willnatsan/autoloader/images/carrier_marker.png

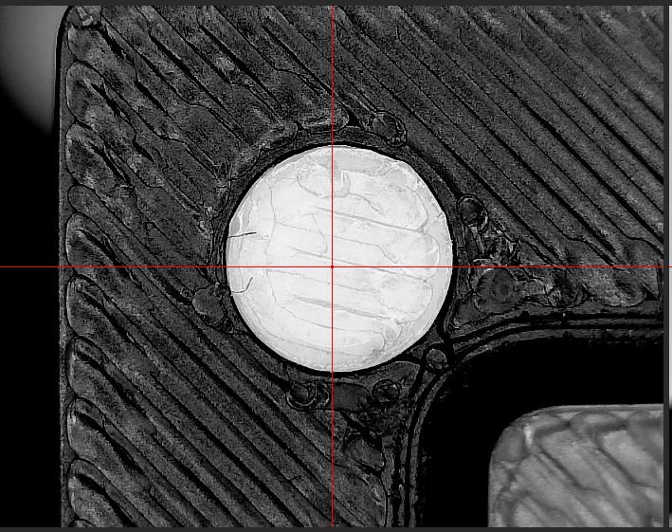
images/carrier_marker.png
