willnatsan/autoloader/images/device_offset.png

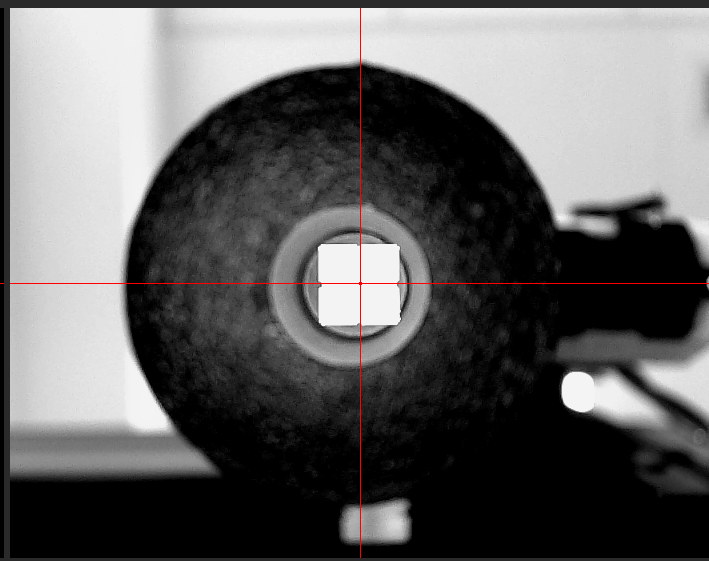
images/device_offset.png
