willnatsan/autoloader/images/device_orient.png

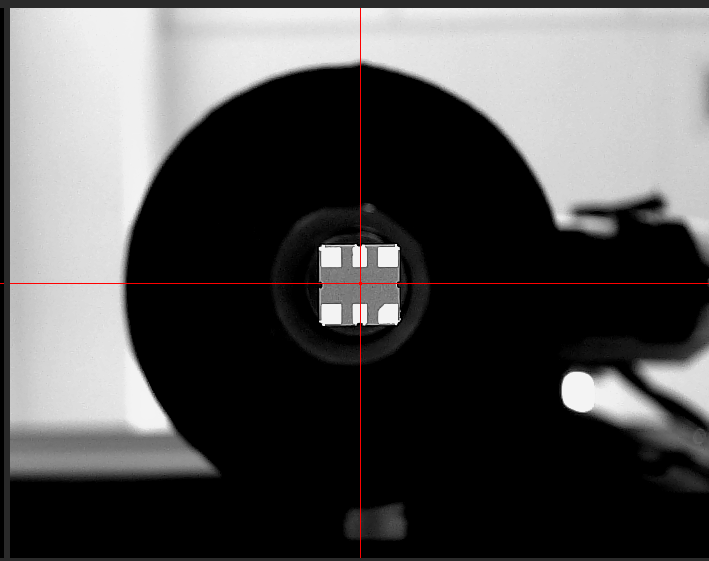
images/device_orient.png
