willnatsan/autoloader/images/phlux_devices.png

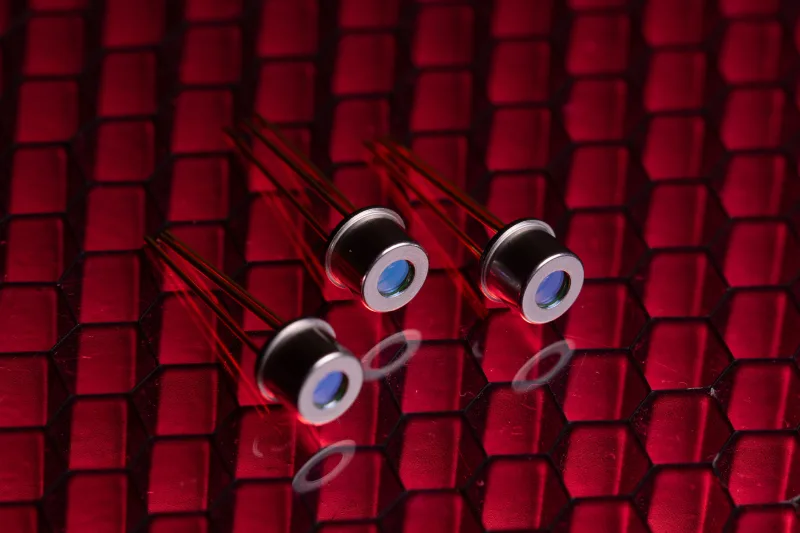
images/phlux_devices.png
