willnatsan/autoloader/images/phlux_group_photo.png

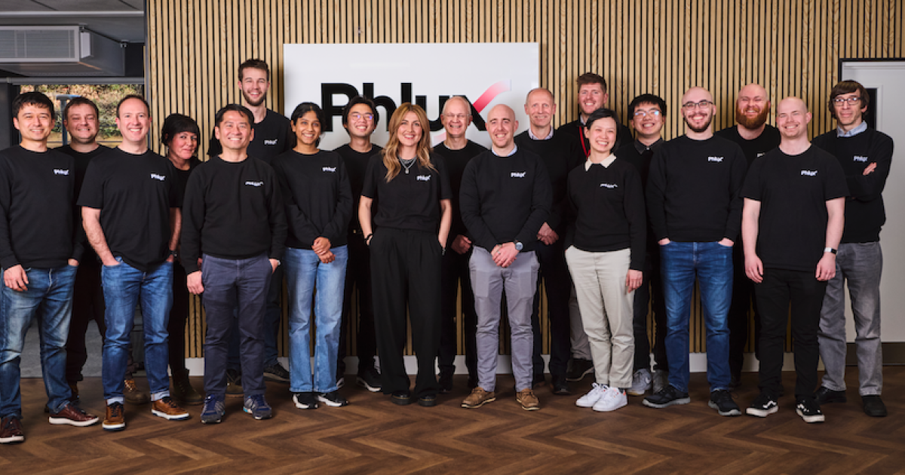
images/phlux_group_photo.png
