willnatsan/autoloader/(list of files, cad)

Other CAD files:
cad/AutoLoader V1 Assembly.step
cad/Upgrade Parts/Micro Servo Gripper Alt/AR4 Gripper Reference/AR4_SG1_assembly.step
cad/Carriers N Mounts/Burn-In Carriers/SMD_Carrier_Board_-_150_Way.step
cad/Carriers N Mounts/SMD-TO Carrier Mount Adapter.step
cad/Device Models/Die v5.step
cad/OG Lumen Parts/belt-tension-arm-left.step
cad/Upgrade Parts/Cable Management/drag-chain-x.step
cad/Upgrade Parts/Cameras/bottom-camera-Body.step
cad/Upgrade Parts/datum-board-mount-Body.step
cad/Upgrade Parts/Micro Servo Gripper Alt/Micro Servo Gripper.step
cad/Upgrade Parts/Micro Servo Gripper/Gripper Finger Alt.step
cad/Carriers N Mounts/Burn-In Carriers/119-01-[SW-A]-001-A.step
cad/Carriers N Mounts/Waffle Pack FINAL.step
cad/Device Models/A440 v13.step
cad/OG Lumen Parts/LML9B-linear-rail-100mm.step
cad/Upgrade Parts/Cable Management/Y Cable Chain Attachment.step
cad/Upgrade Parts/Cameras/bottom-camera-mount-Body.step
cad/Upgrade Parts/Front Right Leg NEW.step
cad/Upgrade Parts/Micro Servo Gripper/Microservo horn.step
cad/Carriers N Mounts/Burn-In Carriers/119-01-[SW-A]-001-A_TO CAN.step
cad/Device Models/A440 Dummy.step
cad/OG Lumen Parts/Unnamed1-vslot-extrusion-20mmx20mmx600mm.step
cad/Upgrade Parts/Cable Management/X Cable Chain Support-dup.step
cad/Upgrade Parts/Cameras/top-light-mount-Body.step
cad/Upgrade Parts/Micro Servo Gripper Alt/SG Gear.step
cad/Upgrade Parts/Micro Servo Gripper/Gripper Spur Gear Alt.step
cad/Upgrade Parts/x-gantry-back-Body.step
cad/Carriers N Mounts/TO Pack Holder FINAL.step
cad/Device Models/TO46 v19.step
cad/OG Lumen Parts/NEMA11-hollow-shaft-stepper.step
cad/Upgrade Parts/Cable Management/drag-chain-end-link-Body.step
cad/Upgrade Parts/Cameras/top-ring-light.step
cad/Upgrade Parts/Front Right Leg Extension.step
cad/Upgrade Parts/Micro Servo Gripper Alt/Rods.step
cad/Upgrade Parts/Micro Servo Gripper/Micro Servo Gripper.step
cad/Carriers N Mounts/Carrier Marker.step
cad/OG Lumen Parts/NEMA17-stepper.step
cad/Upgrade Parts/Cable Management/X Cable Chain Support.step
cad/Upgrade Parts/Cameras/bottom-camera-mount-Body-dup.step
cad/Upgrade Parts/Micro Servo Gripper Alt/SG Gripper.step
cad/Upgrade Parts/Micro Servo Gripper/MG90D v2.step
cad/Upgrade Parts/nozzle-camera-mask-Body.step
cad/Carriers N Mounts/SMD Carrier Mount [NEW].step
cad/OG Lumen Parts/pneumatic-adapter-bracket.step
cad/Upgrade Parts/Cable Management/Chain Mount 2020-Body.step
cad/Upgrade Parts/Cameras/top-camera.step
cad/Upgrade Parts/Micro Servo Gripper Alt/Finger Pad Mold.step
cad/Upgrade Parts/Micro Servo Gripper/Gripper Spur Gear.step
cad/Upgrade Parts/Power Switch Mount.step
cad/Carriers N Mounts/TO Can Jig.step
cad/OG Lumen Parts/y-gantry-left.step
cad/Upgrade Parts/Cable Management/drag-chain-y.step
cad/Upgrade Parts/Cameras/bottom-light-mount-Body.step
cad/Upgrade Parts/Front Left Leg Extension.step
cad/Upgrade Parts/Micro Servo Gripper Alt/Micro Servo Gripper - Alt Gripper.step
cad/Upgrade Parts/Micro Servo Gripper/Gripper Finger.step
cad/Carriers N Mounts/Waffle Pack Holder FINAL.step
cad/OG Lumen Parts/corner-bracket.step
cad/Upgrade Parts/Cable Management/cable-splay.step
cad/Upgrade Parts/Cameras/bottom-ring-light-bottom-ring-light.step
cad/Upgrade Parts/x-motor-mount-NEW.step
cad/OG Lumen Parts/mobo-spacer.step
cad/Upgrade Parts/Cable Management/drag-chain-link.step
cad/Upgrade Parts/Cameras/Bottom Camera Mount [NEW].step
cad/Upgrade Parts/Front Left Leg NEW.step
cad/OG Lumen Parts/vacuum-pump.step
cad/Upgrade Parts/Cameras/bottom-camera-cover-Body.step
cad/Upgrade Parts/Rear Right Leg FIXED.step
cad/OG Lumen Parts/pneumatic-adapter.step
cad/Upgrade Parts/Rear Left Leg FIXED.step
cad/OG Lumen Parts/solenoid-valve.step
cad/Upgrade Parts/MGN12H-725mm.step
cad/OG Lumen Parts/z-gantry.step
cad/Upgrade Parts/Unnamed1-vslot-extrusion-20mmx20mmx800mm.step
cad/OG Lumen Parts/datum-board.step
cad/OG Lumen Parts/staging-plate-foot.step
cad/OG Lumen Parts/x-idler-mount-Body.step
cad/OG Lumen Parts/Staging Plate.step
cad/OG Lumen Parts/MGN12H-550mm.step
cad/OG Lumen Parts/back-leg-extension.step
cad/OG Lumen Parts/rotary-pneumatic-adaptor.step
cad/OG Lumen Parts/umbilical-cable-strain-relief-Body.step
cad/OG Lumen Parts/Staging Plate-dup.step
cad/OG Lumen Parts/valve-mount.step
cad/OG Lumen Parts/mobo-bottom-cover.step
cad/OG Lumen Parts/z-gantry-backplate-left.step
cad/OG Lumen Parts/belt-clamp.step
cad/OG Lumen Parts/nozzle-holder.step
cad/OG Lumen Parts/x-gantry-front-Body.step
cad/OG Lumen Parts/y-gantry-gt2-belt.step
cad/OG Lumen Parts/mobo-top-cover-Body.step
cad/OG Lumen Parts/Limit Switch.step
cad/OG Lumen Parts/nozzle.step
cad/OG Lumen Parts/gt2-idler.step
cad/OG Lumen Parts/Pump Mount.step
cad/OG Lumen Parts/belt-tension-arm-right.step
cad/OG Lumen Parts/motherboard-mobo-3D 1.step
cad/OG Lumen Parts/y-gantry-right.step
cad/OG Lumen Parts/MGN12H-linear-rail-carriage-MGN12H-linear-rail-carriage.step
cad/OG Lumen Parts/gt2-pulley.step
cad/OG Lumen Parts/z-gantry-backplate-right.step
cad/OG Lumen Parts/Staging Plate [Filled].step
cad/AutoLoader V1 Assembly v18.f3z
cad/Carriers N Mounts/Burn-In Carrier Mount [OLD].f3d
cad/Carriers N Mounts/Burn-In Carrier Mount [OLD].step
cad/Carriers N Mounts/Burn-In Carriers/119-01-[SW-A]-001-A.f3d
cad/Carriers N Mounts/Burn-In Carriers/119-01-[SW-A]-001-A_TO CAN.f3d
cad/Carriers N Mounts/Burn-In Carriers/SMD_Carrier_Board_-_150_Way.f3d
cad/Carriers N Mounts/Carrier Marker.f3d
cad/Carriers N Mounts/SMD Carrier Mount [NEW] v11.f3z
cad/Carriers N Mounts/SMD-TO Carrier Mount Adapter.f3d
cad/Carriers N Mounts/TO Can Jig v20.f3z
cad/Carriers N Mounts/TO Pack Holder FINAL v15.f3z
cad/Carriers N Mounts/Waffle Pack FINAL.f3d
cad/Carriers N Mounts/Waffle Pack Holder FINAL v45.f3z
cad/Device Models/A440 Dummy.f3d
cad/Device Models/A440 v13.f3d
cad/Device Models/Die v5.f3d
cad/Device Models/TO46 v19.f3d
cad/OG Lumen Parts/LML9B-linear-rail-100mm.f3d
cad/OG Lumen Parts/Limit Switch.f3d
cad/OG Lumen Parts/MGN12H-550mm.f3d
cad/OG Lumen Parts/MGN12H-linear-rail-carriage-MGN12H-linear-rail-carriage.f3d
cad/OG Lumen Parts/NEMA11-hollow-shaft-stepper.f3d
cad/OG Lumen Parts/NEMA17-stepper.f3d
cad/OG Lumen Parts/Pump Mount.f3d
cad/OG Lumen Parts/Staging Plate [Filled].f3d
cad/OG Lumen Parts/Staging Plate-dup.f3d
cad/OG Lumen Parts/Staging Plate.f3d
cad/OG Lumen Parts/Unnamed1-vslot-extrusion-20mmx20mmx600mm.f3d
cad/OG Lumen Parts/back-leg-extension.f3d
cad/OG Lumen Parts/belt-clamp.f3d
cad/OG Lumen Parts/belt-tension-arm-left.f3d
cad/OG Lumen Parts/belt-tension-arm-right.f3d
cad/OG Lumen Parts/corner-bracket.f3d
cad/OG Lumen Parts/datum-board.f3d
cad/OG Lumen Parts/gt2-idler.f3d
cad/OG Lumen Parts/gt2-pulley.f3d
cad/OG Lumen Parts/mobo-bottom-cover.f3d
cad/OG Lumen Parts/mobo-spacer.f3d
cad/OG Lumen Parts/mobo-top-cover-Body.f3d
cad/OG Lumen Parts/motherboard-mobo-3D 1.f3d
cad/OG Lumen Parts/nozzle-holder.f3d
cad/OG Lumen Parts/nozzle.f3d
cad/OG Lumen Parts/pneumatic-adapter-bracket.f3d
cad/OG Lumen Parts/pneumatic-adapter.f3d
cad/OG Lumen Parts/rotary-pneumatic-adaptor.f3d
cad/OG Lumen Parts/solenoid-valve.f3d
cad/OG Lumen Parts/staging-plate-foot.f3d
cad/OG Lumen Parts/umbilical-cable-strain-relief-Body.f3d
cad/OG Lumen Parts/vacuum-pump.f3d
cad/OG Lumen Parts/valve-mount.f3d
cad/OG Lumen Parts/x-gantry-front-Body.f3d
cad/OG Lumen Parts/x-idler-mount-Body.f3d
cad/OG Lumen Parts/x-motor-mount-OLD.f3d
cad/OG Lumen Parts/x-motor-mount-OLD.step
cad/OG Lumen Parts/y-gantry-gt2-belt.f3d
cad/OG Lumen Parts/y-gantry-left.f3d
cad/OG Lumen Parts/y-gantry-right.f3d
cad/OG Lumen Parts/z-gantry-backplate-left.f3d
cad/OG Lumen Parts/z-gantry-backplate-right.f3d
cad/OG Lumen Parts/z-gantry.f3d
cad/Upgrade Parts/Cable Management/Chain Mount 2020-Body.f3d
cad/Upgrade Parts/Cable Management/X Cable Chain Support-dup.f3d
cad/Upgrade Parts/Cable Management/X Cable Chain Support.f3d
cad/Upgrade Parts/Cable Management/Y Cable Chain Attachment.f3d
cad/Upgrade Parts/Cable Management/cable-splay.f3d
cad/Upgrade Parts/Cable Management/drag-chain-end-link-Body.f3d
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
