willnatsan/autoloader/autoloader_firmware/Marlin/Configuration_adv.h

#define E0_AUTO_FAN_PIN -1
#define E1_AUTO_FAN_PIN -1
#define E2_AUTO_FAN_PIN -1
#define E3_AUTO_FAN_PIN -1
#define E4_AUTO_FAN_PIN -1
#define E5_AUTO_FAN_PIN -1
#define E6_AUTO_FAN_PIN -1
#define E7_AUTO_FAN_PIN -1
#define CHAMBER_AUTO_FAN_PIN -1
#define COOLER_AUTO_FAN_PIN -1
#define HOMING_BUMP_MM {0, 0, 2, 2, 2, 5}      // (linear=mm, rotational=°) Backoff from endstops after first bump
#define HOMING_BUMP_DIVISOR {2, 2, 4, 4, 4, 2} // Re-Bump Speed Divisor (Divides the Homing Feedrate)
#define MICROSTEP_MODES {16, 16, 16, 16, 16, 16} // [1,2,4,8,16]
#define X_CURRENT 800       // (mA) RMS current. Multiply by 1.414 for peak current.
#define X_CURRENT_HOME 1000 // (mA) RMS current for sensorless homing
#define X_MICROSTEPS 64     // 0..256
#define Y_CURRENT 1000
#define Y_CURRENT_HOME 1500
#define Y_MICROSTEPS 64
#define Z_CURRENT 800
#define Z_CURRENT_HOME Z_CURRENT
#define Z_MICROSTEPS 8
#define I_CURRENT 200
#define I_CURRENT_HOME I_CURRENT
#define I_MICROSTEPS 8
#define J_CURRENT 200
#define J_CURRENT_HOME J_CURRENT
#define J_MICROSTEPS 8
#define K_CURRENT 800
#define K_CURRENT_HOME K_CURRENT
#define K_MICROSTEPS 16
#define X_HYBRID_THRESHOLD 100 // [mm/s]
#define X2_HYBRID_THRESHOLD 100
#define Y_HYBRID_THRESHOLD 100
#define Y2_HYBRID_THRESHOLD 100
#define Z_HYBRID_THRESHOLD 3
#define Z2_HYBRID_THRESHOLD 3
#define Z3_HYBRID_THRESHOLD 3
#define Z4_HYBRID_THRESHOLD 3
#define I_HYBRID_THRESHOLD 3 // [linear=mm/s, rotational=°/s]
#define J_HYBRID_THRESHOLD 3 // [linear=mm/s, rotational=°/s]
#define K_HYBRID_THRESHOLD 3 // [linear=mm/s, rotational=°/s]
#define U_HYBRID_THRESHOLD 3 // [mm/s]
#define V_HYBRID_THRESHOLD 3
#define W_HYBRID_THRESHOLD 3
#define E0_HYBRID_THRESHOLD 30
#define E1_HYBRID_THRESHOLD 30
#define E2_HYBRID_THRESHOLD 30
#define E3_HYBRID_THRESHOLD 30
#define E4_HYBRID_THRESHOLD 30
#define E5_HYBRID_THRESHOLD 30
#define E6_HYBRID_THRESHOLD 30
#define E7_HYBRID_THRESHOLD 30
#define SENSORLESS_HOMING // StallGuard capable drivers only
#define SENSORLESS_STALLGUARD_DELAY 20
#define X_STALL_SENSITIVITY 120
#define X2_STALL_SENSITIVITY X_STALL_SENSITIVITY
#define Y_STALL_SENSITIVITY 100
#define Y2_STALL_SENSITIVITY Y_STALL_SENSITIVITY
#define TMC_HOME_PHASE {896, 896, 896}
