willnatsan/autoloader/autoloader_data/autoloader_data/src/coords.yaml

BOTTOM_CAMERA:
  x: 318.82
  y: 47.85
  z: 27.6
HOMING_FIDUCIAL:
  x: 317.6
  y: 93.2
  z: 0.0
SMD_CARRIER:
  failed_slots: null
  marker_radius: 79
  markers:
  - - 297.8
    - 357.8
  - - 127.8
    - 357.8
  - - 127.8
    - 187.8
  run_slots:
  - - 0
    - 0
  slots:
  - - 0
    - 0
  - - 0
    - 1
  - - 0
    - 2
  - - 0
    - 3
  - - 0
    - 4
  - - 0
    - 5
  - - 0
    - 6
  - - 0
    - 7
  - - 0
    - 8
  - - 0
    - 9
  - - 0
    - 10
  - - 0
    - 11
  - - 1
    - 0
  - - 1
    - 1
  - - 1
    - 2
  - - 1
    - 3
  - - 1
    - 4
  - - 1
    - 5
  - - 1
    - 6
  - - 1
    - 7
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
  x_increment: -13.0
  y: 344.3
  y_increment: -13.0
  z: 26.5
SMD_WAFFLE:
  failed_slots: null
  marker_radius: 118
  markers:
  - - 459.85
    - 206.2
  - - 566.45
    - 206.2
  - - 566.45
    - 99.6
  run_slots:
  - - 0
    - 0
  slots:
  - - 0
    - 0
  - - 1
    - 0
  - - 2
    - 0
  - - 3
    - 0
  - - 4
    - 0
  - - 5
    - 0
  - - 6
    - 0
  - - 7
    - 0
  - - 8
    - 0
  - - 9
    - 0
  - - 10
    - 0
  - - 11
    - 0
  - - 12
    - 0
  - - 13
    - 0
  - - 14
    - 0
  - - 15
    - 0
  - - 0
    - 1
  - - 1
    - 1
  - - 2
    - 1
  - - 3
    - 1
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
  x_increment: 5.5
  y: 194.15
  y_increment: -5.5
  z: 26.5
TO_CARRIER:
  failed_slots: null
  marker_radius: 150
  markers:
  - - 297.7
    - 350.05
  - - 127.7
    - 350.05
  - - 127.7
    - 196.05
  run_slots:
  - - 0
    - 0
  slots:
  - - 0
    - 0
  - - 0
    - 1
  - - 0
    - 2
  - - 0
    - 3
  - - 0
    - 4
  - - 0
    - 5
  - - 0
    - 6
  - - 0
    - 7
  - - 0
    - 8
  - - 0
    - 9
  - - 0
    - 10
  - - 0
    - 11
  - - 1
    - 0
  - - 1
    - 1
  - - 1
    - 2
  - - 1
    - 3
  - - 1
    - 4
  - - 1
    - 5
  - - 1
    - 6
  - - 1
    - 7
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
  x_increment: -13.0
  y: 344.55
  y_increment: -13.0
  z: 25.0
TO_PLACEMENT_JIG:
  x: 407.8
  y: 288.25
  z: 25.0
TO_WAFFLE:
  failed_slots: null
  marker_radius: 118
  markers:
  - - 424.65
    - 343.95
  - - 600.65
    - 343.95
  - - 600.65
    - 231.95
  run_slots:
  - - 0
    - 0
  slots:
  - - 0
    - 0
  - - 1
    - 0
  - - 2
    - 0
  - - 3
    - 0
  - - 4
    - 0
  - - 5
    - 0
  - - 6
    - 0
  - - 7
    - 0
  - - 8
    - 0
  - - 9
    - 0
  - - 10
    - 0
  - - 11
    - 0
  - - 12
    - 0
  - - 13
    - 0
  - - 14
    - 0
  - - 15
    - 0
  - - 16
    - 0
  - - 17
    - 0
  - - 18
    - 0
  - - 19
    - 0
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
  x_increment: 7.55
  y: 324.8
  y_increment: -8.55
  z: 25.0
