willnatsan/autoloader/(commit log)

2025-09-04 uploading CAD files
    [119-01-[SW-A]-001-A.f3d, 119-01-[SW-A]-001-A.step, 119-01-[SW-A]-001-A_TO CAN.f3d, 119-01-[SW-A]-001-A_TO CAN.step, A440 Dummy.f3d, A440 Dummy.step, A440 v13.f3d, A440 v13.step]
2025-10-05 update README.md -> Trying to insert images
