willnatsan/autoloader/(notices)

Notices in the files:
autoloader_firmware/Marlin/Configuration.h:
Copyright (c) 2021 MarlinFirmware [https://github.com/MarlinFirmware/Marlin]
Copyright (c) 2011 Camiel Gubbels / Erik van der Zalm
This program is free software: you can redistribute it and/or modify
it under the terms of the GNU General Public License as published by
the Free Software Foundation, either version 3 of the License, or
(at your option) any later version.
autoloader_firmware/Marlin/Configuration_adv.h:
define TOUCH_UI_UTF8_COPYRIGHT // © ®
